ericpearson1313/tt_grid_tie_load/docs/1d23834.png

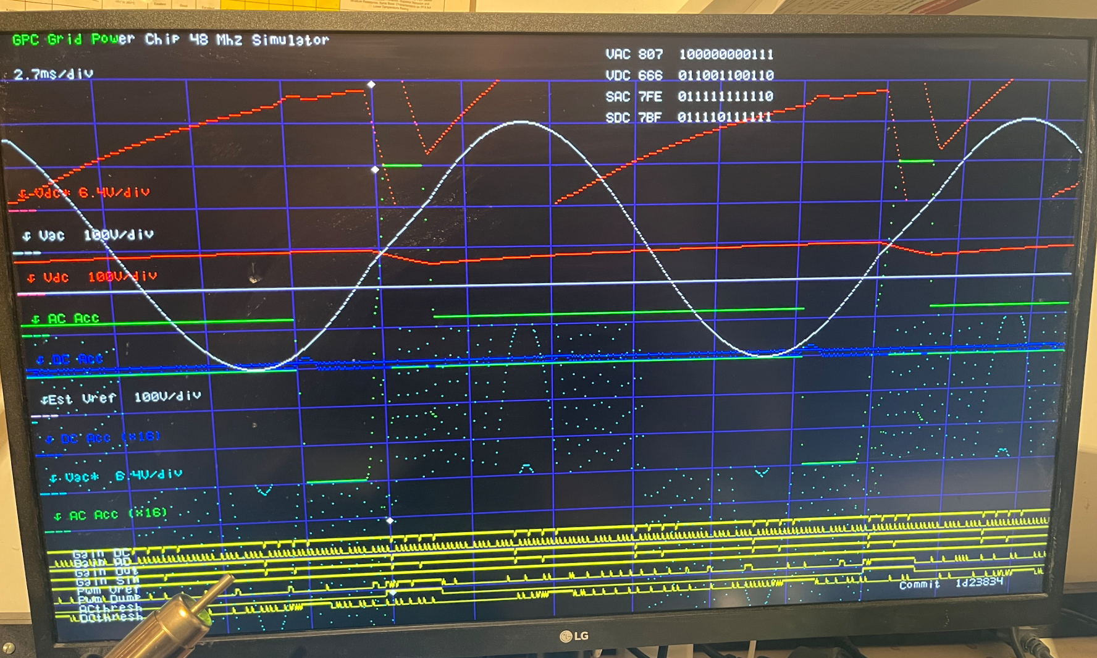
docs/1d23834.png
