ericpearson1313/tt_grid_tie_load/pcb/GPC_dev_board.kicad_pcb

## KiCad design pcb/GPC_dev_board.kicad_pcb (2026-07-01)

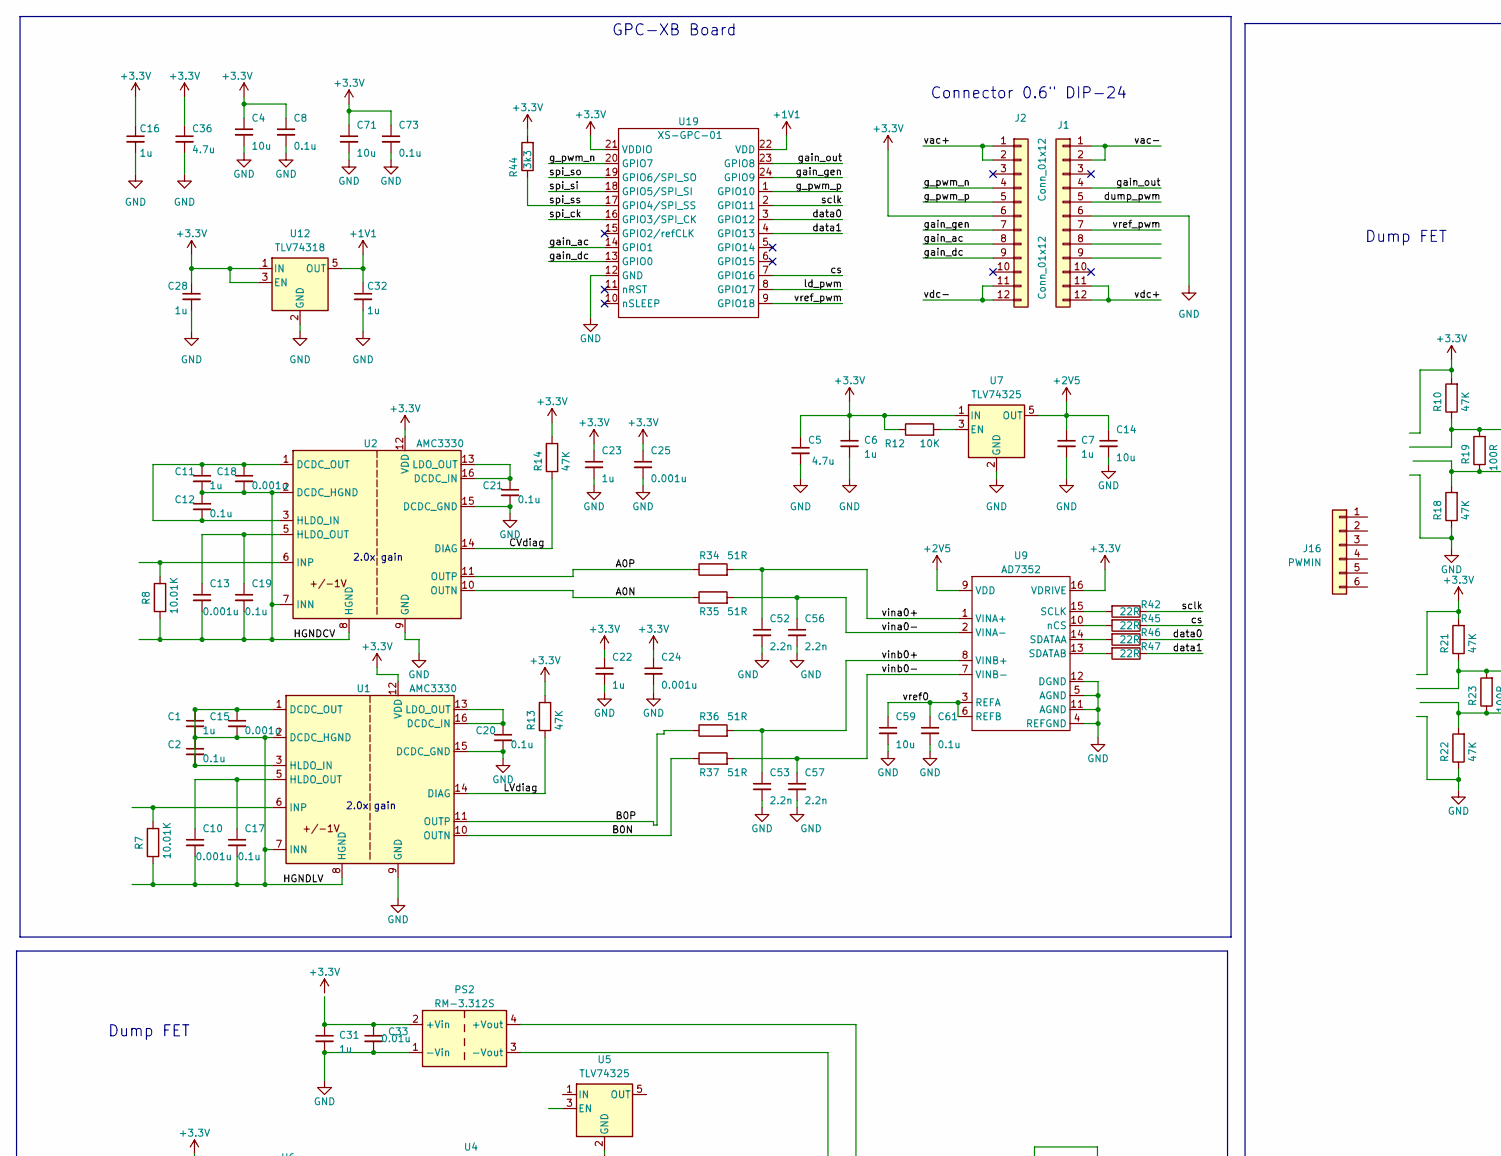
[picture p7: schematic GPC_dev_board.kicad_sch, XS-GPC-01-XB Engineering Board, part in row 1, column 1]

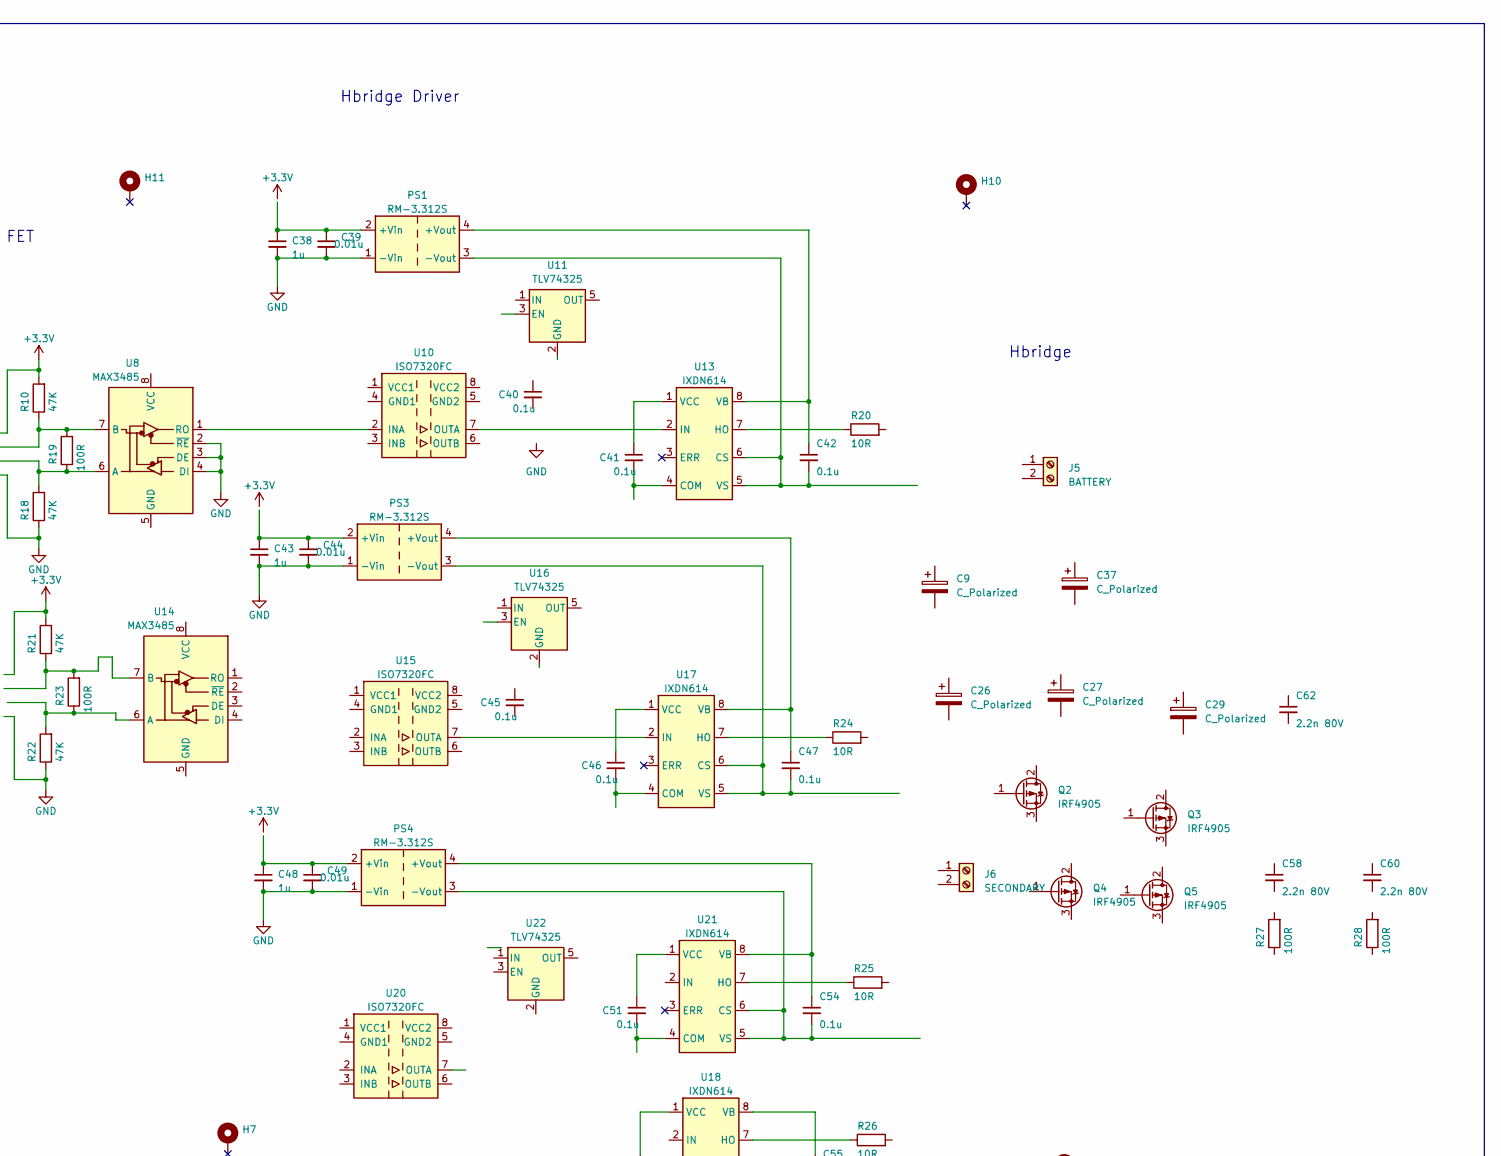
[picture p8: schematic GPC_dev_board.kicad_sch, XS-GPC-01-XB Engineering Board, part in row 1, column 2]

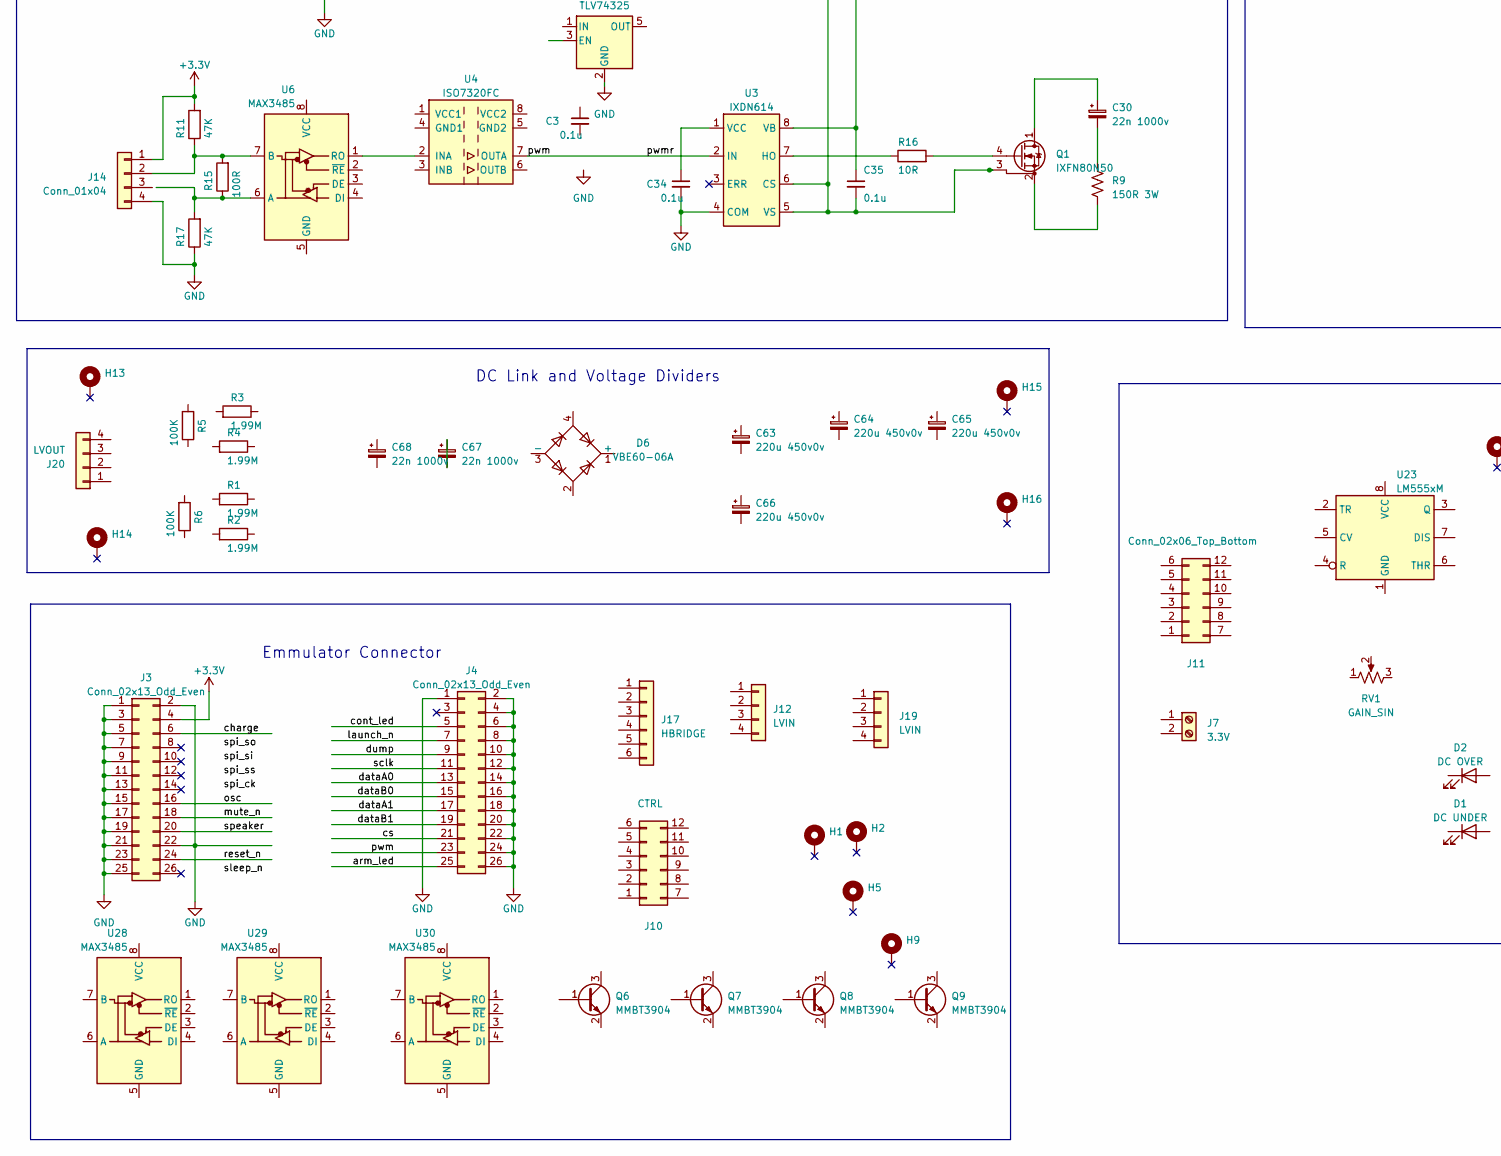
[picture p9: schematic GPC_dev_board.kicad_sch, XS-GPC-01-XB Engineering Board, part in row 2, column 1]

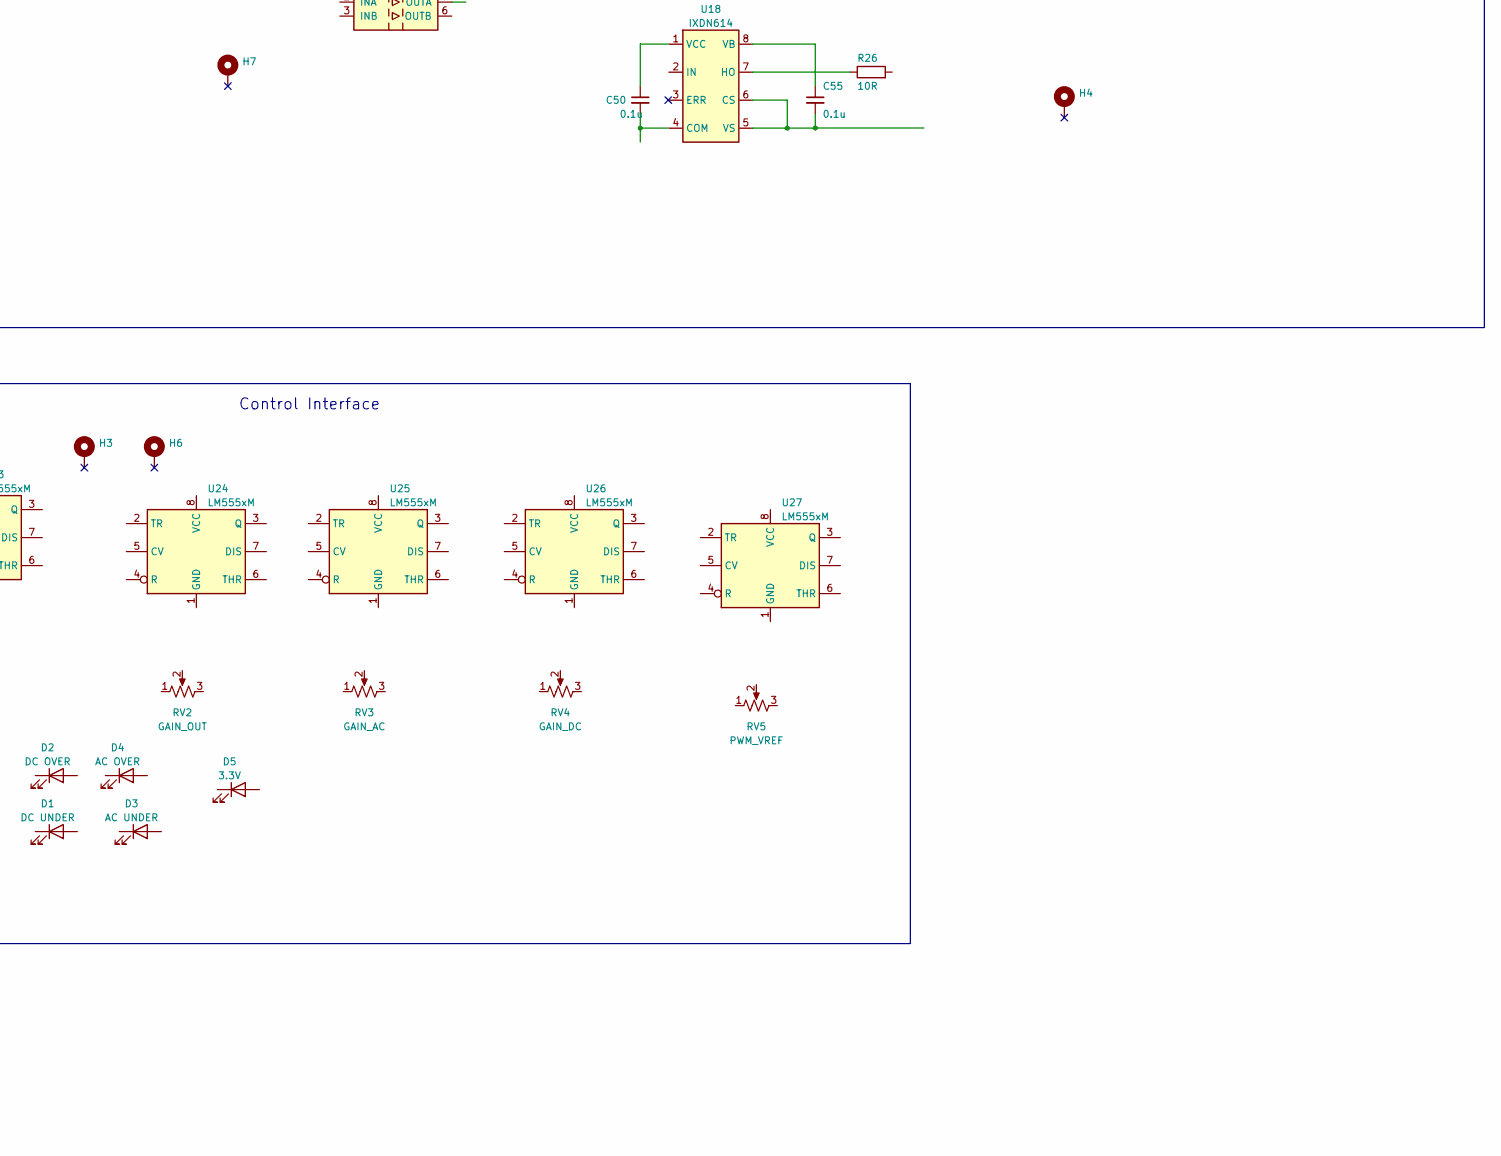
[picture p10: schematic GPC_dev_board.kicad_sch, XS-GPC-01-XB Engineering Board, part in row 2, column 2]

Parts:
C1, C6, C7, C11, C16, C22, C23, C28, C31, C32, C38, C43, C48: 1u; C_0603_1608Metric
C2, C3, C8, C12, C17, C19, C20, C21, C34, C35, C40, C41, C42, C45, C46, C47, C50, C51, C54, C55, C61, C73: 0.1u; C_0603_1608Metric
C4, C14, C59, C71: 10u; C_1206_3216Metric
C5, C36: 4.7u; C_1206_3216Metric
C9, C26, C27, C29, C37: C_Polarized; CP_Radial_D10.0mm_P5.00mm
C10, C13, C15, C18, C24, C25: 0.001u; C_0603_1608Metric
C30, C67, C68: 22n 1000v; C_Rect_L13.0mm_W6.0mm_P10.00mm_FKS3_FKP3_MKS4
C33, C39, C44, C49: 0.01u; C_0603_1608Metric
C52, C53, C56, C57: 2.2n; C_0603_1608Metric
C58, C60, C62: 2.2n 80V; C_0603_1608Metric
C63, C64, C65, C66: 220u 450v0v; CP_Radial_D18.0mm_P7.50mm
D1: DC UNDER; LED_0603_1608Metric
D2: DC OVER; LED_0603_1608Metric
D3: AC UNDER; LED_0603_1608Metric
D4: AC OVER; LED_0603_1608Metric
D5: 3.3V; LED_0603_1608Metric
D6: VBE60-06A; SOT-227
H1, H2, H3, H4, H5, H6, H7, H9, H10, H11, H13, H14, H15, H16: MountingHole_3mm_Pad
J1, J2: Conn_01x12; PinHeader_1x12_P2.54mm_Vertical
J3, J4: Conn_02x13_Odd_Even; PinSocket_2x13_P2.54mm_Vertical
J5: BATTERY; TerminalBlock_Phoenix_MKDS-1,5-2-5.08_1x02_P5.08mm_Horizont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
J6: SECONDARY; TerminalBlock_Phoenix_MKDS-1,5-2-5.08_1x02_P5.08mm_Horizont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
J7: 3.3V; TerminalBlock_Phoenix_MKDS-1,5-2-5.08_1x02_P5.08mm_Horizont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
J10: CTRL; PinHeader_2x06_P2.54mm_Vertical
J11: Conn_02x06_Top_Bottom; PinHeader_2x06_P2.54mm_Horizontal
J12, J19: LVIN; PinHeader_1x04_P2.54mm_Vertical
J14: Conn_01x04; PinHeader_1x04_P2.54mm_Horizontal
J16: PWMIN; PinHeader_1x06_P2.54mm_Horizontal
J17: HBRIDGE; PinHeader_1x06_P2.54mm_Vertical
J20: LVOUT; PinHeader_1x04_P2.54mm_Horizontal
PS1, PS2, PS3, PS4: RM-3.312S; Converter_DCDC_Murata_MEE1SxxxxSC_THT
Q1: IXFN80N50; SOT-227
Q2, Q3, Q4, Q5: IRF4905; TO-220-3_Horizontal_TabDown
Q6, Q7, Q8, Q9: MMBT3904; SOT-23
R1, R2, R3, R4: 1.99M; R_2512_6332Metric; JLC C778416
R5, R6: 100K; R_2512_6332Metric; JLC C778416
R7, R8: 10.01K; R_0603_1608Metric; JLC C778416
R9: 150R 3W; R_2512_6332Metric
R10, R11, R13, R14, R17, R18, R21, R22: 47K; R_0603_1608Metric; JLC C778416
R12: 10K; R_0603_1608Metric; JLC C778416
R15, R19, R23, R27, R28: 100R; R_0603_1608Metric; JLC C778416
R16, R20, R24, R25, R26: 10R; R_0603_1608Metric; JLC C778416
R34, R35, R36, R37: 51R; R_0603_1608Metric; JLC C778416
R42, R45, R46, R47: 22R; R_0603_1608Metric; JLC C319967
R44: 3k3; R_0603_1608Metric; JLC C319967
RV1: GAIN_SIN; Potentiometer_Bourns_3299X_Horizontal
RV2: GAIN_OUT; Potentiometer_Bourns_3299X_Horizontal
RV3: GAIN_AC; Potentiometer_Bourns_3299X_Horizontal
RV4: GAIN_DC; Potentiometer_Bourns_3299X_Horizontal
RV5: PWM_VREF; Potentiometer_Bourns_3299X_Horizontal
U1, U2: AMC3330; SOIC-16W_7.5x10.3mm_P1.27mm
U3, U13, U17, U18, U21: IXDN614; SOIC-8_3.9x4.9mm_P1.27mm
U4, U10, U15, U20: ISO7320FC; SOIC-8_3.9x4.9mm_P1.27mm
U5, U7, U11, U16, U22: TLV74325; SOT-23-5
U6, U8, U14, U28, U29, U30: MAX3485; SOIC-8_3.9x4.9mm_P1.27mm
U9: AD7352; TSSOP-16_4.4x5mm_P0.65mm
U12: TLV74318; SOT-23-5
U19: XS-GPC-01; QFN-24-3x3mm
U23, U24, U25, U26, U27: LM555xM; SOIC-8_3.9x4.9mm_P1.27mm

Connections:
+1V1: C32.1, U12.5 (OUT), U19.22 (VDD)
+2V5: C7.1, C14.1, U7.5 (OUT), U9.9 (VDD)
+3.3V: C4.1, C5.1, C6.1, C8.1, C16.1, C22.1, C23.1, C24.1, C25.1, C28.1, C36.1, C71.1, C73.1, J2.6, J3.4, J14.1, R10.2, R11.2, R12.1, R13.2, R14.2, R21.2, R44.2, U1.12 (VDD), U2.12 (VDD), U7.1 (IN), U9.16 (VDRIVE), U12.1 (IN), U12.3 (EN), U19.21 (VDDIO)
/A0N: R35.1, U2.10 (OUTN)
/A0P: R34.1, U2.11 (OUTP)
/B0N: R37.1, U1.10 (OUTN)
/B0P: R36.1, U1.11 (OUTP)
/CVdiag: R14.1, U2.14 (DIAG)
/HGNDCV: C11.2, C12.1, C13.2, C18.2, C19.2, R8.1, U2.2 (DCDC_HGND), U2.7 (INN), U2.8 (HGND)
/HGNDLV: C1.1, C1.2, C2.1, C2.2, C10.2, C15.1, C15.2, C17.2, R7.1, U1.1 (DCDC_OUT), U1.2 (DCDC_HGND), U1.3 (HLDO_IN), U1.7 (INN), U1.8 (HGND)
/LVdiag: R13.1, U1.14 (DIAG)
/arm_led: J4.25
/charge: J3.6
/cont_led: J4.5
/cs: J4.21, R45.1, U19.7 (GPIO16)
/data0: R46.1, U19.3 (GPIO12)
/data1: R47.1, U19.4 (GPIO13)
/dataA0: J4.13
/dataA1: J4.17
/dataB0: J4.15
/dataB1: J4.19
/dump: J4.9
/dump_pwm: J1.5
/g_pwm_n: J2.4, U19.20 (GPIO7)
/g_pwm_p: J2.5, U19.1 (GPIO10)
/gain_ac: J2.8, U19.14 (GPIO1)
/gain_dc: J2.9, U19.13 (GPIO0)
/gain_gen: J2.7, U19.24 (GPIO9)
/gain_out: J1.4, U19.23 (GPIO8)
/launch_n: J4.7
/ld_pwm: U19.8 (GPIO17)
/mute_n: J3.18
/osc: J3.16
/pwm: J4.23, U4.7 (OUTA)
/reset_n: J3.24
/sclk: J4.11, R42.1, U19.2 (GPIO11)
/speaker: J3.20
/spi_ck: U19.16 (GPIO3/SPI_CK)
/spi_si: U19.18 (GPIO5/SPI_SI)
/spi_so: U19.19 (GPIO6/SPI_SO)
/spi_ss: R44.1, U19.17 (GPIO4/SPI_SS)
/vac+: J2.1, J2.2
/vac-: J1.1, J1.2
/vdc+: J1.11, J1.12
/vdc-: J2.11, J2.12
/vina0+: C52.1, R34.2, U9.1 (VINA+)
/vina0-: C56.1, R35.2, U9.2 (VINA-)
/vinb0+: C53.1, R36.2, U9.8 (VINB+)
/vinb0-: C57.1, R37.2, U9.7 (VINB-)
/vref0: C59.1, C61.1, U9.3 (REFA), U9.6 (REFB)
/vref_pwm: J1.7, U19.9 (GPIO18)
GND: C4.2, C5.2, C6.2, C7.2, C8.2, C14.2, C16.2, C20.2, C21.2, C22.2, C23.2, C24.2, C25.2, C28.2, C31.2, C32.2, C33.2, C34.2, C36.2, C38.2, C39.2, C43.2, C44.2, C48.2, C49.2, C52.2, C53.2, C56.2, C57.2, C59.2, C61.2, C71.2, C73.2, J1.6, J3.1, J3.2, J3.3, J3.5, J3.7, J3.9, J3.11, J3.13, J3.15, J3.17, J3.19, J3.21, J3.22, J3.23, J3.25, J4.1, J4.2, J4.4, J4.6, J4.8, J4.10, J4.12, J4.14, J4.16, J4.18, J4.20, J4.22, J4.24, J4.26, J14.4, PS1.1 (-Vin), PS2.1 (-Vin), PS3.1 (-Vin), PS4.1 (-Vin), R17.1, R18.1, R22.1, U1.9 (GND), U1.15 (DCDC_GND), U2.9 (GND), U2.15 (DCDC_GND), U5.2 (GND), U7.2 (GND), U8.2 (~RE), U8.3 (DE), U8.4 (DI), U9.4 (REFGND), U9.5 (AGND), U9.11 (AGND), U9.12 (DGND), U12.2 (GND), U19.12 (GND)
unnamed: C30.2, R9.1
unnamed: C67.1, C67.2
unnamed: J14.2, R11.1, R15.2, U6.7 (B)
unnamed: C38.1, C39.1, PS1.2 (+Vin)
unnamed: C42.1, PS1.4 (+Vout)
unnamed: C42.2, PS1.3 (-Vout)
unnamed: C31.1, C33.1, PS2.2 (+Vin)
unnamed: C35.1, PS2.4 (+Vout)
unnamed: C35.2, PS2.3 (-Vout), Q1.3 (DS)
unnamed: C43.1, C44.1, PS3.2 (+Vin)
unnamed: C47.1, PS3.4 (+Vout)
unnamed: C47.2, PS3.3 (-Vout)
unnamed: C48.1, C49.1, PS4.2 (+Vin)
unnamed: C54.1, PS4.4 (+Vout)
unnamed: C54.2, PS4.3 (-Vout)
unnamed: C30.1, Q1.1 (D)
unnamed: Q1.4 (G), R16.2
unnamed: Q1.2 (S), R9.2
unnamed: C20.1, U1.13 (LDO_OUT), U1.16 (DCDC_IN)
unnamed: C10.1, C17.1, U1.5 (HLDO_OUT)
unnamed: R7.2, U1.6 (INP)
unnamed: C21.1, U2.13 (LDO_OUT), U2.16 (DCDC_IN)
unnamed: C11.1, C12.2, C18.1, U2.1 (DCDC_OUT), U2.3 (HLDO_IN)
unnamed: C13.1, C19.1, U2.5 (HLDO_OUT)
unnamed: R8.2, U2.6 (INP)
unnamed: U4.2 (INA), U6.1 (RO)
unnamed: R15.1, R17.2, U6.6 (A)
unnamed: R12.2, U7.3 (EN)
unnamed: R18.2, R19.1, U8.6 (A)
unnamed: R10.1, R19.2, U8.7 (B)
unnamed: R42.2, U9.15 (SCLK)
unnamed: R46.2, U9.14 (SDATAA)
unnamed: R47.2, U9.13 (SDATAB)
unnamed: R45.2, U9.10 (nCS)
unnamed: U8.1 (RO), U10.2 (INA)
unnamed: R22.2, R23.1, U14.6 (A)
unnamed: R21.1, R23.2, U14.7 (B)

Notes on the sheet:
Connector 0.6" DIP-24
GPC-XB Board
Dump FET
2.0x gain
DC Link and Voltage Dividers
Hbridge Driver
Control Interface
Emmulator Connector
Hbridge

Board: 6 copper layers, 194 parts (20 on the bottom side), 71 nets, no tracks yet.

Other parts of the board:
C64#2, C64#3, C64#4, C64#5, C64#6, C64#7, C64#8: 220u 450v0v; CP_Radial_D18.0mm_P7.50mm
