ericpearson1313/tt_grid_tie_load/grid_forge/ffpga/src/adc_in.sv

// vim: ts=4:
// Two cahnnels 0,1
module adc_in
(
	// Input clock,
	input wire clk,
	input wire reset,
	
	// External A/D Converters (2.5v)
	output reg  ad_cs,
	input  wire  [1:0] ad_sdata,
	
	// ADC monitor outputs
	output wire [11:0] ad_out0,
	output wire [11:0] ad_out1,
	output reg ad_strobe
);

// ADC sample pulse 
// RUn ADCs in-continuous mode.
// The fall of the CS signal is actually the moment of sampling, and MSB becomes valid
parameter HOLD_SEL = 15;  // select output hold delay bit 1 cyclce early but account for input regs
parameter ADCS_SEL = 15;  // early CS output cycle 


reg [3:0] sample_div = 0;
initial sample_div = 0;
always @(posedge clk) sample_div <= ( reset ) ? 0 : sample_div + 1;

// ad_cs reg is to be I/O_reg
// ad_cs is active during sample_div == 0;
always @(posedge clk) 
	ad_cs <= ( sample_div == ADCS_SEL ) ? 1'b1 : 1'b0;

// DATA Input I/O registers
reg [1:0] ad_ireg;
always @(posedge clk)
	ad_ireg <= ad_sdata;

// Data input shift regisers MSB first
reg [11:0] ad_sreg0, ad_sreg1;;
always @(posedge clk) begin
  if( reset ) begin
	ad_sreg0 <= 0;
	ad_sreg1 <= 0;
  end else begin
		ad_sreg0 <= { ad_sreg0[10:0], ad_ireg[0] };
		ad_sreg1 <= { ad_sreg1[10:0], ad_ireg[1] };
  end
end

// Data hold registers
reg ad_hold_en;
always @(posedge clk) 
	ad_hold_en <= ( sample_div == HOLD_SEL ) ? 1'b1 : 1'b0;
reg [11:0] ad_hold0, ad_hold1;
always @(posedge clk) 
  if( reset ) begin
	ad_hold0 <= 0;
	ad_hold1 <= 0;
  end else begin
		ad_hold0 <= ( ad_hold_en ) ? ad_sreg0 : ad_hold0;
		ad_hold1 <= ( ad_hold_en ) ? ad_sreg1 : ad_hold1;
  end
// ad_strobe reg
always @(posedge clk) ad_strobe <= ad_hold_en;

// Output optional negation
// data outputs with negation
assign ad_out0 = ad_hold0 ^ 12'h800;
assign ad_out1 = ad_hold1 ^ 12'h800;

endmodule
