ericpearson1313/tt_grid_tie_load/(commit log)

2026-05-25 getting flow running?
2026-05-26 boiler plate sim running, linked in cordic
2026-05-26 109% utilization, move to a 1x2, we still have ADC logic to add
2026-05-26 very fine 20ns pwm edge res, and top level basic test on 1 cycle
2026-06-01 Add Vref pwm input for DC loop
2026-06-07 Updated forge code, fixup, in sync but 105% util
    [project.v]
2026-06-07 port/copy asic->fpga flow 94%
2026-06-08 put absin reg back in without reset
    [project.v]
2026-06-09 Add tb pwm and cordic, datapath fully running, replicate cordic.v for GL sims
2026-06-15 conditional FPGA probes inside TT, got chip video connected and can see/zoom 60 Hz Vac. capture/monitor 5 signed and 8 binary signals.
2026-06-17 FPGA sim fixes (wiring) and ADC simulator external pads, single 1.3s run with capture power steps of 100W each 1/4 sec.
    [grid_tie_chip.sv]
2026-06-17 Tighten dc acc -ve limit and dc low signalling
    [project.v]
2026-06-18 Fix flops to use nonblocking <=
    [dclink_model.sv]
2026-06-18 Simulation FPGA re-order sections and added 2nd test (dc gain ramp to tighten Vdc envelope (`ifdef to select test for now)
    [grid_tie_chip.sv]
2026-06-18 Update forge to current TT (with cordic!)
2026-06-21 Development board for chip bringup thinking added to datasheet.
2026-06-22 Early rough kicad project and initial floorplan of development board
    [GPC_dev_board.kicad_pcb, GPC_dev_board.kicad_sch]
2026-07-01 development system pcb(s) floorplan
    [GPC_dev_board.kicad_pcb, GPC_dev_board.kicad_sch]
